elliotnor/TSEA29-Proj/Docs/Gruppkontrakt_sign.pdf

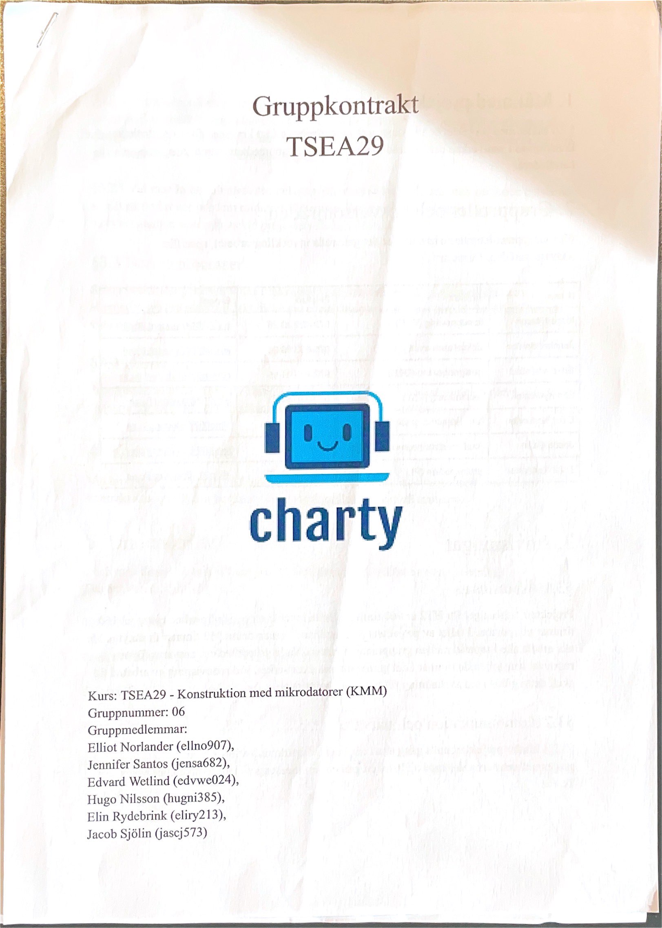
[picture p35: page 1]
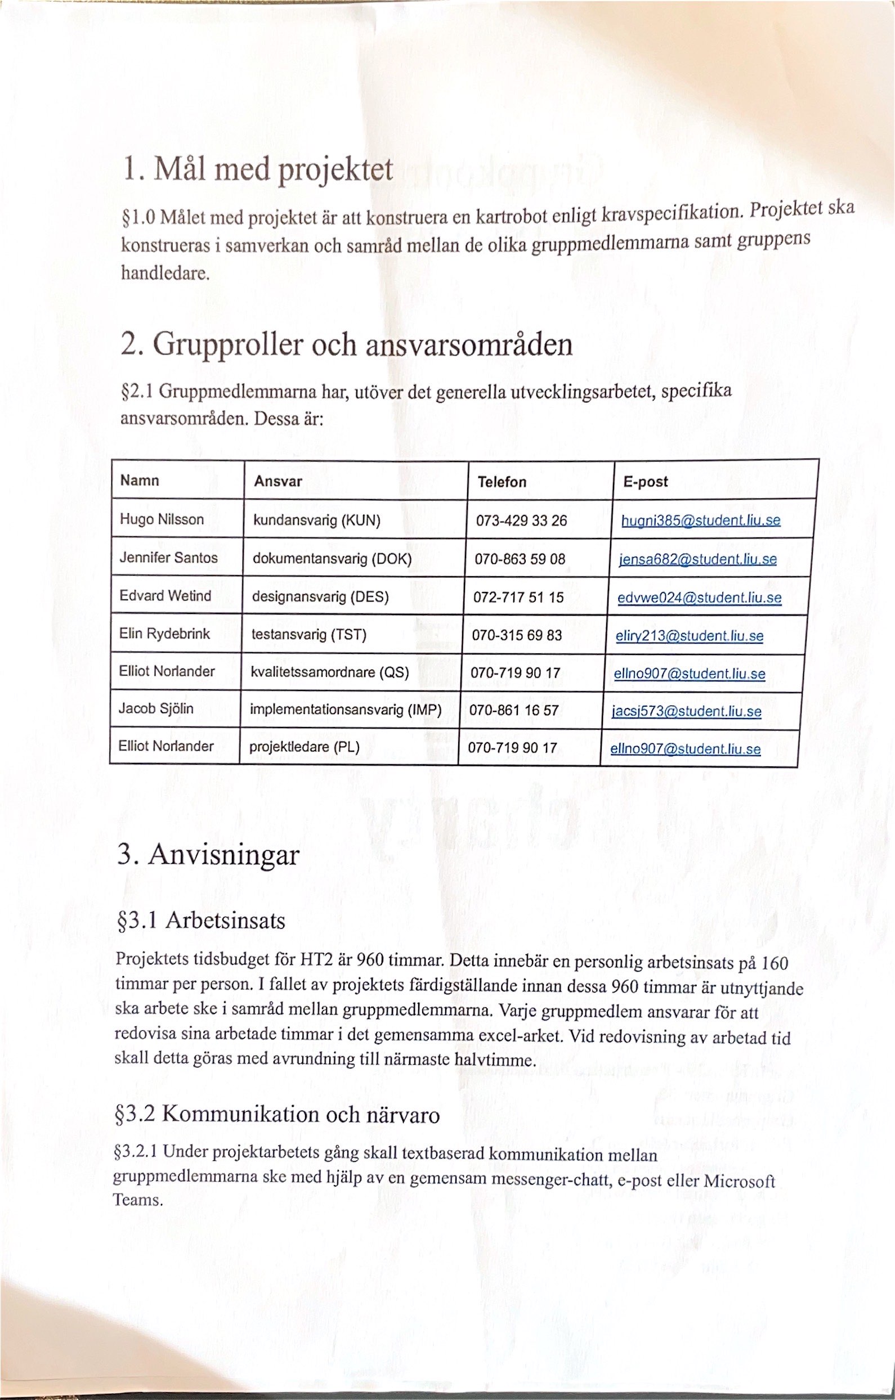
[picture p36: page 2]
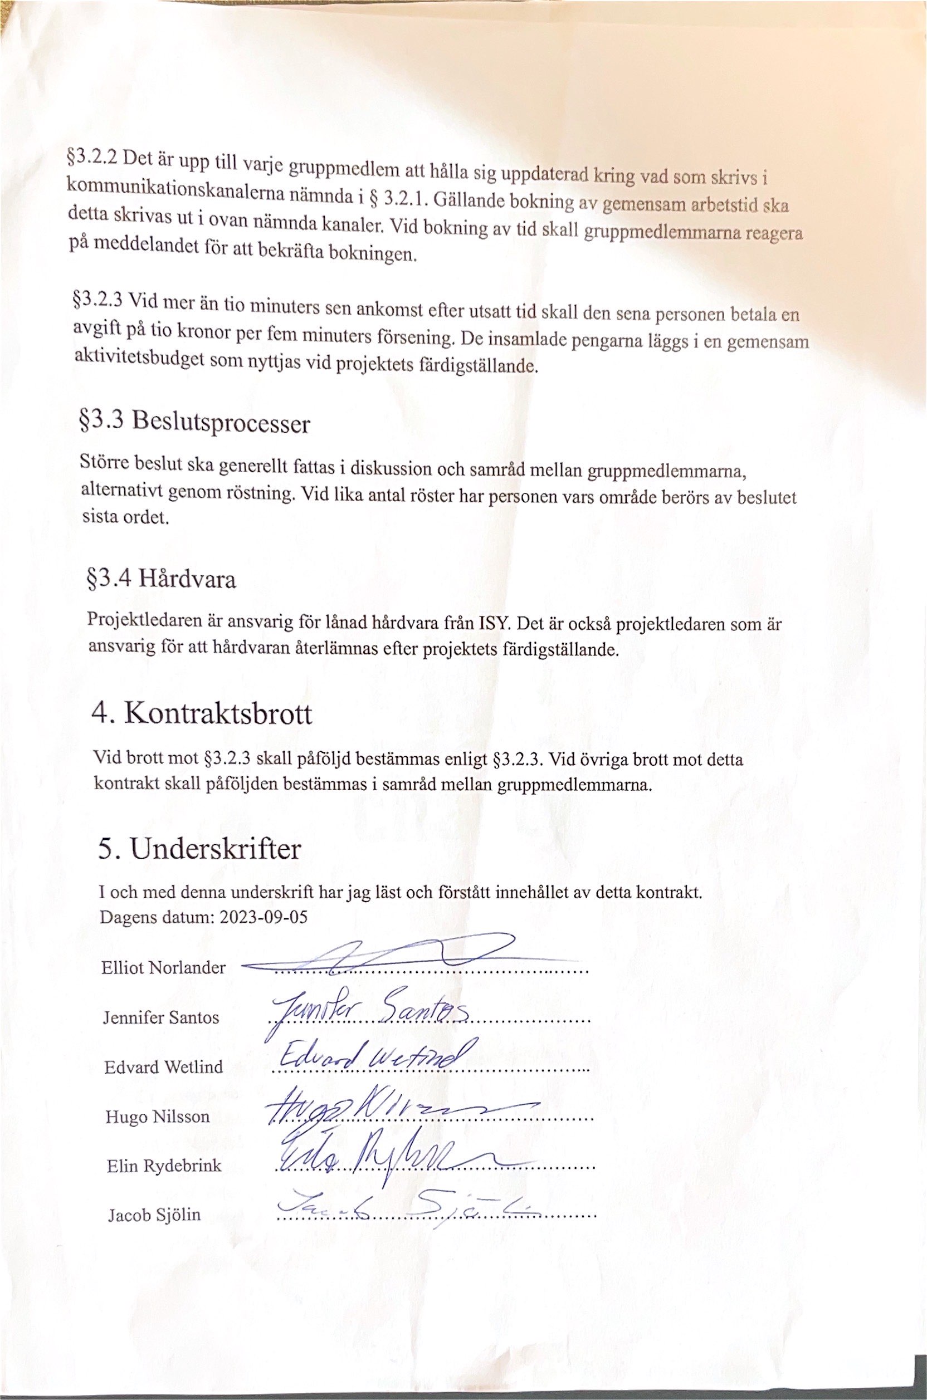
[picture p37: page 3]
