elliotnor/TSEA29-Proj/Docs/tidplan/TidsRapport_V44.xlsx

Sheet: Basplan
Basplan
Projekt:
Projektgrupp: |  | G06 |  | Datum: |  | 2023-11-06 |  |  |  |  |  |  | Granskad: |  |  |  |  |  |  |  |  |  |  |  |  |  |  |  | Planering / HT1
Beställare: |  | Anders Nilsson |  | Version: |  | 1.0 |  |  |  |  |  |  |  |  |  |  |  |  |  |  |  |  |  |  |  |  |  |  | TENTA-P (inget arbete med projektet)
Kurs: |  | TSEA29 |  | Utfärdare: |  | Elliot Norlander |  |  |  |  |  |  |  |  |  |  |  |  |  |  |  |  |  |  |  |  |  |  | Utveckling / HT2
AKTIVITETER |  |  | TID | VEM | TIDPLAN (när), veckonummer |  |  |  |  |  |  |  |  |  |  |  |  |  |  |  |  |  |  |  |  |  |  |  | Redovisning / Efterarbete
Nr | Beskrivning |  | timmar | Initialer | 35 | 36 | 37 | 38 | 39 | 40 | 41 | 42 | 43 | 44 | 45 | 46 | 47 | 48 | 49 | 50 | 51 | 52
1 | Designspec |  |  | ALLA |  |  |  |  |  |  |  |  |  |  |  |  |  |  |  |  |  |  |  |  |  |  |  | 0
2 | Raspberry PI setup |  | 4 | EN, EW |  |  |  |  |  |  |  |  |  | 4 |  |  |  |  |  |  |  |  |  |  |  |  |  | 4
3 | Kommunikationsmodul |  | 80 | JSA, JSJ, HN |  |  |  |  |  |  |  |  |  | 30 | 25 | 25 |  |  |  |  |  |  |  |  |  |  |  | 80
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
