elliotnor/TSEA29-Proj/Code/sensormodul/todo.txt

[] change order in which the ADC ports is read. Currently incorrect. PA0 (AD0) is only read when ADMUX is XXX00000 and so on.

Questions;
1. Måste en extern spänningsreferens användas?
2. Måste ADC-pins vara konfiguererade till input för att kunna acceptera data?
