elliotnor/TSEA29-Proj/Docs/tidplan/TSEA29_Tidsplan_G06_V0.1.pdf

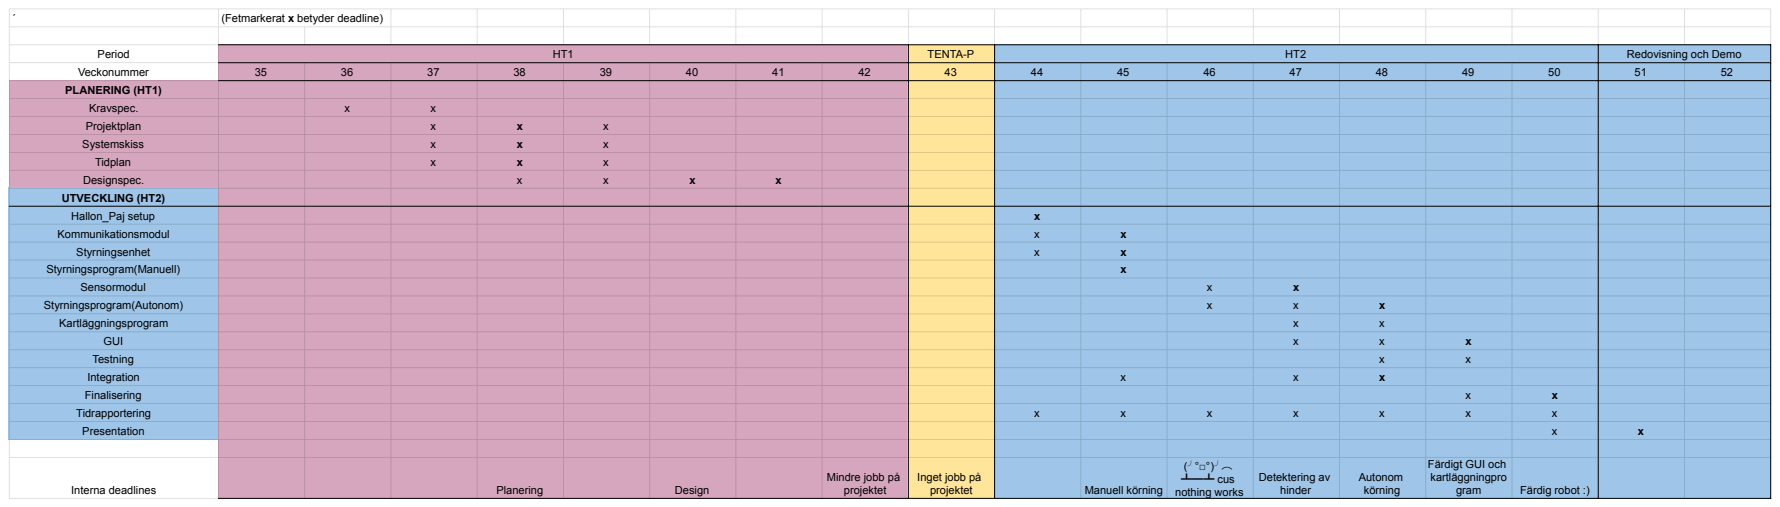
[picture p50: page 1]
(Fetmarkerat x betyder deadline)

Period Veckonummer | HT1 | TENTA-P | HT2 | Redovisning och Demo
35 36 37 38 39 40 41 42 | 43 | 44 45 46 47 48 49 50 | 51 52
PLANERING (HT1) Kravspec. x x Projektplan x x x Systemskiss x x x Tidplan x x x Designspec. x x x x

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

Interna deadlines | Planering Design Mindre jobb på projektet | Inget jobb på projektet | (╯°□°)╯︵ Färdigt GUI och Manuell körning ┻━┻ cus nothing works Detektering av hinder Autonom kartläggningpro körning gram Färdig robot :)
